robzach/capitalism-works-for-me/(list of files, drawings)

Other design files:
capPodiumCircuit/capPodiumCircuit.fzz
