robzach/capitalism-works-for-me/capSignV17/sevenSegFunctions.ino

/*
  Function: find proper code and pass it to be sent
  Note:
  0b(dp)GFEDCBA
*/
void sevenSegDisplayChar(char displayChar, boolean group)
{
  switch (displayChar) //find proper code
  {
    case '^': //space
      if (!group)
      {
        //0
        digitalWrite(sevenSegDataPinFalse , LOW); //
        digitalWrite(sevenSegClockPinFalse, LOW);
        digitalWrite(sevenSegClockPinFalse, HIGH);
        digitalWrite(sevenSegDataPinFalse , LOW); //
        digitalWrite(sevenSegClockPinFalse, LOW);
        digitalWrite(sevenSegClockPinFalse, HIGH);
        digitalWrite(sevenSegDataPinFalse , LOW); //
        digitalWrite(sevenSegClockPinFalse, LOW);
        digitalWrite(sevenSegClockPinFalse, HIGH);
        digitalWrite(sevenSegDataPinFalse , LOW); //
        digitalWrite(sevenSegClockPinFalse, LOW);
        digitalWrite(sevenSegClockPinFalse, HIGH);
        digitalWrite(sevenSegDataPinFalse , LOW); //
        digitalWrite(sevenSegClockPinFalse, LOW);
        digitalWrite(sevenSegClockPinFalse, HIGH);
        digitalWrite(sevenSegDataPinFalse , LOW); //
        digitalWrite(sevenSegClockPinFalse, LOW);
        digitalWrite(sevenSegClockPinFalse, HIGH);
        digitalWrite(sevenSegDataPinFalse , LOW); //
        digitalWrite(sevenSegClockPinFalse, LOW);
        digitalWrite(sevenSegClockPinFalse, HIGH);
        digitalWrite(sevenSegDataPinFalse , LOW); //
        digitalWrite(sevenSegClockPinFalse, LOW);
        digitalWrite(sevenSegClockPinFalse, HIGH);

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
        digitalWrite(sevenSegClockPinFalse, LOW);
        digitalWrite(sevenSegClockPinFalse, HIGH);
        digitalWrite(sevenSegDataPinFalse , HIGH); //
        digitalWrite(sevenSegClockPinFalse, LOW);
        digitalWrite(sevenSegClockPinFalse, HIGH);

        digitalWrite(sevenSegLatchPinFalse, LOW);
        digitalWrite(sevenSegLatchPinFalse, HIGH);

      }
      else
      {
        sevenSegSendRaw(0b01111111, group);
      }
      break;
    case '9':
    case 'g':
      if (!group)
      {
        digitalWrite(sevenSegDataPinFalse , LOW); //
        digitalWrite(sevenSegClockPinFalse, LOW);
        digitalWrite(sevenSegClockPinFalse, HIGH);
        digitalWrite(sevenSegDataPinFalse , HIGH); //
        digitalWrite(sevenSegClockPinFalse, LOW);
        digitalWrite(sevenSegClockPinFalse, HIGH);
        digitalWrite(sevenSegDataPinFalse , HIGH); //
        digitalWrite(sevenSegClockPinFalse, LOW);
        digitalWrite(sevenSegClockPinFalse, HIGH);
        digitalWrite(sevenSegDataPinFalse , LOW); //
        digitalWrite(sevenSegClockPinFalse, LOW);
        digitalWrite(sevenSegClockPinFalse, HIGH);
        digitalWrite(sevenSegDataPinFalse , HIGH); //
        digitalWrite(sevenSegClockPinFalse, LOW);
        digitalWrite(sevenSegClockPinFalse, HIGH);
        digitalWrite(sevenSegDataPinFalse , HIGH); //
        digitalWrite(sevenSegClockPinFalse, LOW);
        digitalWrite(sevenSegClockPinFalse, HIGH);
        digitalWrite(sevenSegDataPinFalse , HIGH); //
        digitalWrite(sevenSegClockPinFalse, LOW);
        digitalWrite(sevenSegClockPinFalse, HIGH);
        digitalWrite(sevenSegDataPinFalse , HIGH); //
        digitalWrite(sevenSegClockPinFalse, LOW);
        digitalWrite(sevenSegClockPinFalse, HIGH);

        digitalWrite(sevenSegLatchPinFalse, LOW);
        digitalWrite(sevenSegLatchPinFalse, HIGH);
      }
      else
      {
        sevenSegSendRaw(0b01101111, group);
      }
      break;
    case 'A':
      sevenSegSendRaw(0b01110111, group);
      break;
    case 'b':
      sevenSegSendRaw(0b01111100, group);
      break;
    case 'C':
      sevenSegSendRaw(0b00111001, group);
      break;
    case 'd':
      sevenSegSendRaw(0b01011110, group);
      break;
    case 'E':
      sevenSegSendRaw(0b01111001, group);
      break;
    case 'F':
      sevenSegSendRaw(0b01110001, group);
      break;
    case 'J':
      sevenSegSendRaw(0b00011110, group);
      break;
    case 'o':
      sevenSegSendRaw(0b01011100, group);
      break;
    case 'u':
      sevenSegSendRaw(0b00011100, group);
      break;
    case 'y':
      sevenSegSendRaw(0b01101110, group);
      break;
    case '-':
      sevenSegSendRaw(0b01000000, group);
      break;
    default:
      sevenSegSendRaw(0b00000000, group);
  }
  return;
}

/*
  Function: send code to display
*/
void sevenSegSendRaw(int code, boolean group)
{
  if (group)
  {
    shiftOut(sevenSegDataPinTrue, sevenSegClockPinTrue, MSBFIRST, code); //msb shift
  }
  else
  {
    shiftOut(sevenSegDataPinFalse, sevenSegClockPinFalse, MSBFIRST, code); //msb shift
  }
  return;
}
