robzach/capitalism-works-for-me/(commit log)

2018-04-06 initial commit of Arduino 1.8.5 version (thought was already uploaded, my error)
2018-04-12 pulling RTS pin low
2018-05-08 added capPodiumCircuit v0.1 as sent to Oshpark for PCB fabrication on 5-6-18
    [capPodiumCircuit.fzz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]
2018-05-21 changed Amazon links to hyperlinks so they wouldn't screw up table formatting
